hrandib/upsv2/kicad/ups_top.jpg

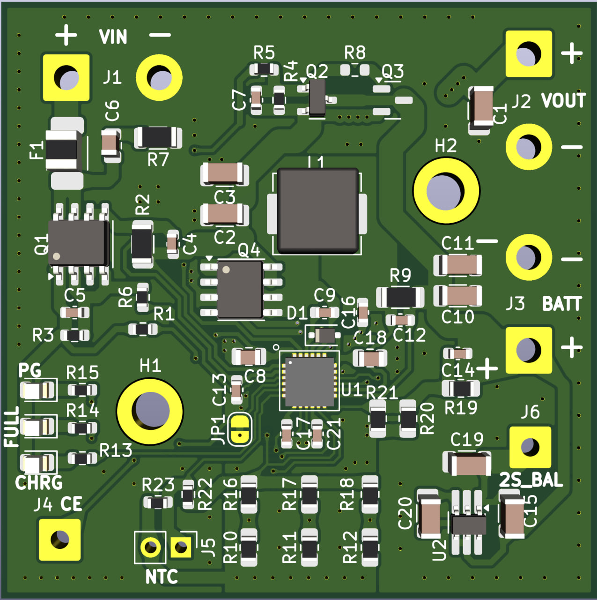
kicad/ups_top.jpg
