hrandib/upsv2/kicad/ups_bottom.jpg

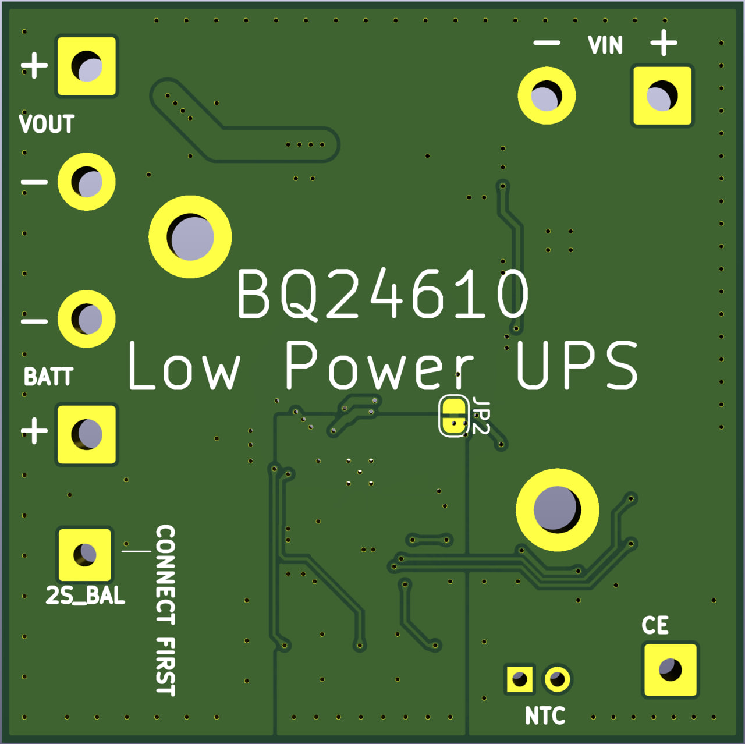
kicad/ups_bottom.jpg
