hrandib/upsv2/kicad/ups.kicad_pcb

## KiCad design kicad/ups.kicad_pcb (2024-06-22)

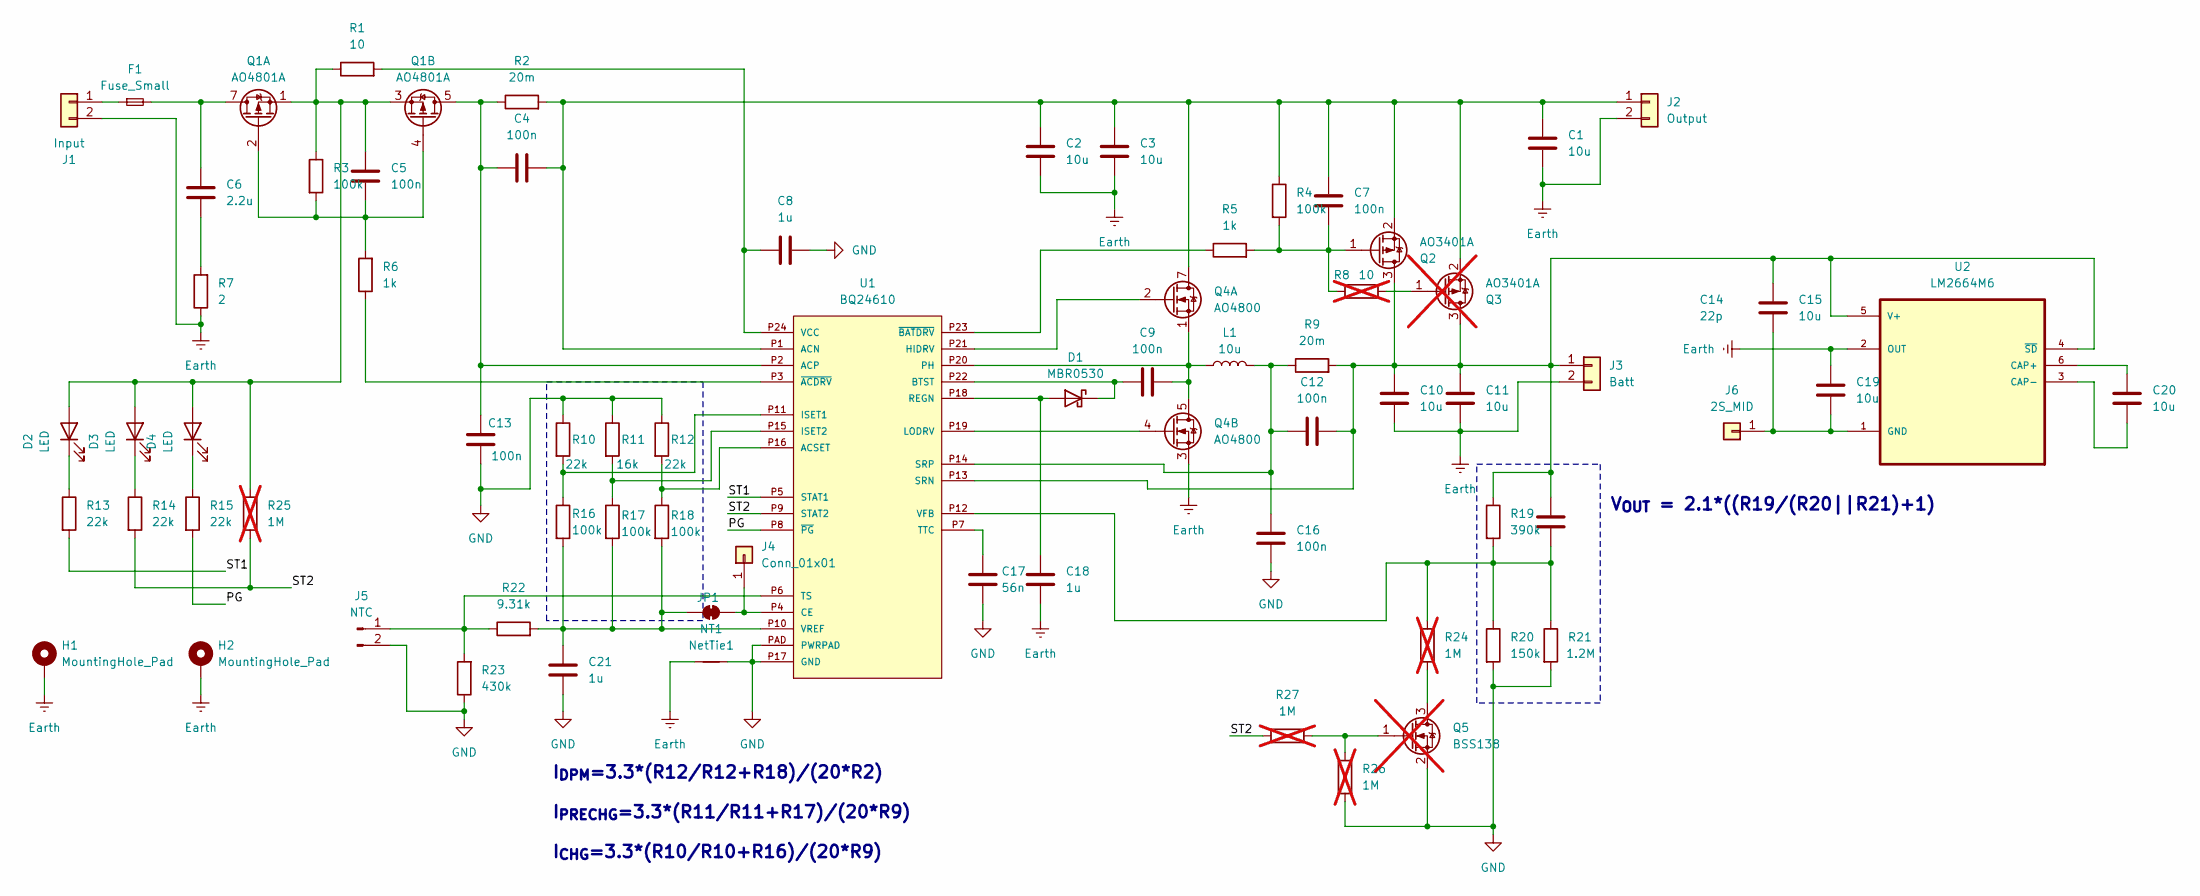
[picture p3: schematic ups.kicad_sch]

Parts:
C1, C2, C3, C10, C11, C15, C19, C20: 10u; C_1206_3216Metric
C4, C5, C7, C9, C12, C13, C16: 100n; C_0603_1608Metric
C6: 2.2u; C_0805_2012Metric
C8, C18: 1u; C_0805_2012Metric
C14: 22p; C_0603_1608Metric
C17: 56n; C_0603_1608Metric
C21: 1u; C_0603_1608Metric
D1: MBR0530; D_SOD-323F
D2, D3, D4: LED; LED_0805_2012Metric
F1: Fuse_Small; Fuse_1812_4532Metric
H1, H2: MountingHole_Pad; MountingHole_3.2mm_M3_DIN965_Pad
J1: Input; SolderWire-1.5sqmm_1x02_P7.8mm_D1.7mm_OD3.9mm
J2: Output; SolderWire-1.5sqmm_1x02_P7.8mm_D1.7mm_OD3.9mm
J3: Batt; SolderWire-1.5sqmm_1x02_P7.8mm_D1.7mm_OD3.9mm
J4: Conn_01x01; SolderWire-0.75sqmm_1x01_D1.25mm_OD3.5mm
J5: NTC; PinHeader_1x02_P2.54mm_Vertical
J6: 2S_MID; SolderWire-0.75sqmm_1x01_D1.25mm_OD3.5mm
JP1: SolderJumper_2_Bridged; SolderJumper-2_P1.3mm_Bridged_RoundedPad1.0x1.5mm
L1: 10u; L_Abracon_ASPI-0630LR
NT1: NetTie1; NetTie-2_SMD_Pad2.0mm
Q1: AO4801A; SOIC-8_3.9x4.9mm_P1.27mm
Q2: AO3401A; SOT-23
Q3: AO3401A; SOT-23; not fitted
Q4: AO4800; SOIC-8_3.9x4.9mm_P1.27mm
Q5: BSS138; SOT-23; not fitted
R1: 10; R_0603_1608Metric
R2, R9: 20m; R_1206_3216Metric
R3, R4: 100k; R_0603_1608Metric
R5, R6: 1k; R_0603_1608Metric
R7: 2; R_1206_3216Metric
R8: 10; R_0603_1608Metric; not fitted
R10, R12: 22k; R_0805_2012Metric_Pad1.20x1.40mm_HandSolder
R11: 16k; R_0805_2012Metric_Pad1.20x1.40mm_HandSolder
R13, R14, R15: 22k; R_0603_1608Metric
R16, R17, R18: 100k; R_0805_2012Metric_Pad1.20x1.40mm_HandSolder
R19: 390k; R_0805_2012Metric_Pad1.20x1.40mm_HandSolder
R20: 150k; R_0805_2012Metric_Pad1.20x1.40mm_HandSolder
R21: 1.2M; R_0805_2012Metric_Pad1.20x1.40mm_HandSolder
R22: 9.31k; R_0603_1608Metric
R23: 430k; R_0603_1608Metric
R24: 1M; R_0805_2012Metric_Pad1.20x1.40mm_HandSolder; not fitted
R25, R26, R27: 1M; R_0603_1608Metric; not fitted
U1: BQ24610; VQFN24_TI
U2: LM2664M6; TSOT-23-6_HandSoldering

Connections:
/PG: R15.2, U1.P8 (~PG)
/ST1: R13.2, U1.P5 (STAT1)
/ST2: R14.2, R25.2, R27.1, U1.P9 (STAT2)
Earth: C1.2, C2.2, C3.2, C10.2, C11.2, C18.2, C19.1, H1.1, H2.1, J1.2, J2.2, J3.2, NT1.2, Q4.3 (S2), R7.1, U2.2 (OUT)
GND: C8.2, C13.1, C16.1, C17.2, C21.2, J5.2, NT1.1, Q5.2 (S), R10.1, R11.1, R12.1, R20.2, R21.2, R23.1, R26.2, U1.P17 (GND), U1.PAD (PWRPAD)
unnamed: C6.1, F1.2, Q1.7 (D1), Q1.8 (D1)
unnamed: C6.2, R7.2
unnamed: C18.1, D1.2 (A), U1.P18 (REGN)
unnamed: C9.1, D1.1 (K), U1.P22 (BTST)
unnamed: C5.1, D2.2 (A), D3.2 (A), D4.2 (A), Q1.1 (S1), Q1.3 (S2), R1.1, R3.1, R25.1
unnamed: D2.1 (K), R13.1
unnamed: D3.1 (K), R14.1
unnamed: D4.1 (K), R15.1
unnamed: F1.1, J1.1
unnamed: C1.1, C2.1, C3.1, C4.2, C7.1, J2.1, Q2.2 (S), Q3.2 (S), Q4.7 (D1), Q4.8 (D1), R2.2, R4.1, U1.P1 (ACN)
unnamed: C10.1, C11.1, C12.2, C14.1, C15.1, J3.1, Q2.3 (D), Q3.3 (D), R9.2, R19.1, U1.P13 (SRN), U2.4 (~SD), U2.5 (V+)
unnamed: J4.1, JP1.2 (B), U1.P4 (CE)
unnamed: J5.1, R22.1, R23.2, U1.P6 (TS)
unnamed: C15.2, C19.2, J6.1, U2.1 (GND)
unnamed: C21.1, JP1.1 (A), R16.2, R17.2, R18.2, R22.2, U1.P10 (VREF)
unnamed: C5.2, Q1.2 (G1), Q1.4 (G2), R3.2, R6.2
unnamed: C7.2, Q2.1 (G), R4.2, R5.2, R8.1
unnamed: Q3.1 (G), R8.2
unnamed: Q4.2 (G1), U1.P21 (HIDRV)
unnamed: C9.2, L1.1, Q4.1 (S1), Q4.5 (D2), Q4.6 (D2), U1.P20 (PH)
unnamed: Q4.4 (G2), U1.P19 (LODRV)
unnamed: Q5.3 (D), R24.2
unnamed: Q5.1 (G), R26.1, R27.2
unnamed: C4.1, C13.2, Q1.5 (D2), Q1.6 (D2), R2.1, U1.P2 (ACP)
unnamed: R12.2, R18.1, U1.P16 (ACSET)
unnamed: R10.2, R16.1, U1.P11 (ISET1)
unnamed: R11.2, R17.1, U1.P15 (ISET2)
unnamed: C12.1, C16.2, L1.2, R9.1, U1.P14 (SRP)
unnamed: C17.1, U1.P7 (TTC)
unnamed: C8.1, R1.2, U1.P24 (VCC)
unnamed: C14.2, R19.2, R20.1, R21.1, R24.1, U1.P12 (VFB)
unnamed: R6.1, U1.P3 (~ACDRV)
unnamed: R5.1, U1.P23 (~BATDRV)
unnamed: C20.1, U2.6 (CAP+)
unnamed: C20.2, U2.3 (CAP-)

Notes on the sheet:
V_{OUT} = 2.1*((R19/(R20||R21)+1)
I_{DPM}=3.3*(R12/R12+R18)/(20*R2) I_{PRECHG}=3.3*(R11/R11+R17)/(20*R9) I_{CHG}=3.3*(R10/R10+R16)/(20*R9)

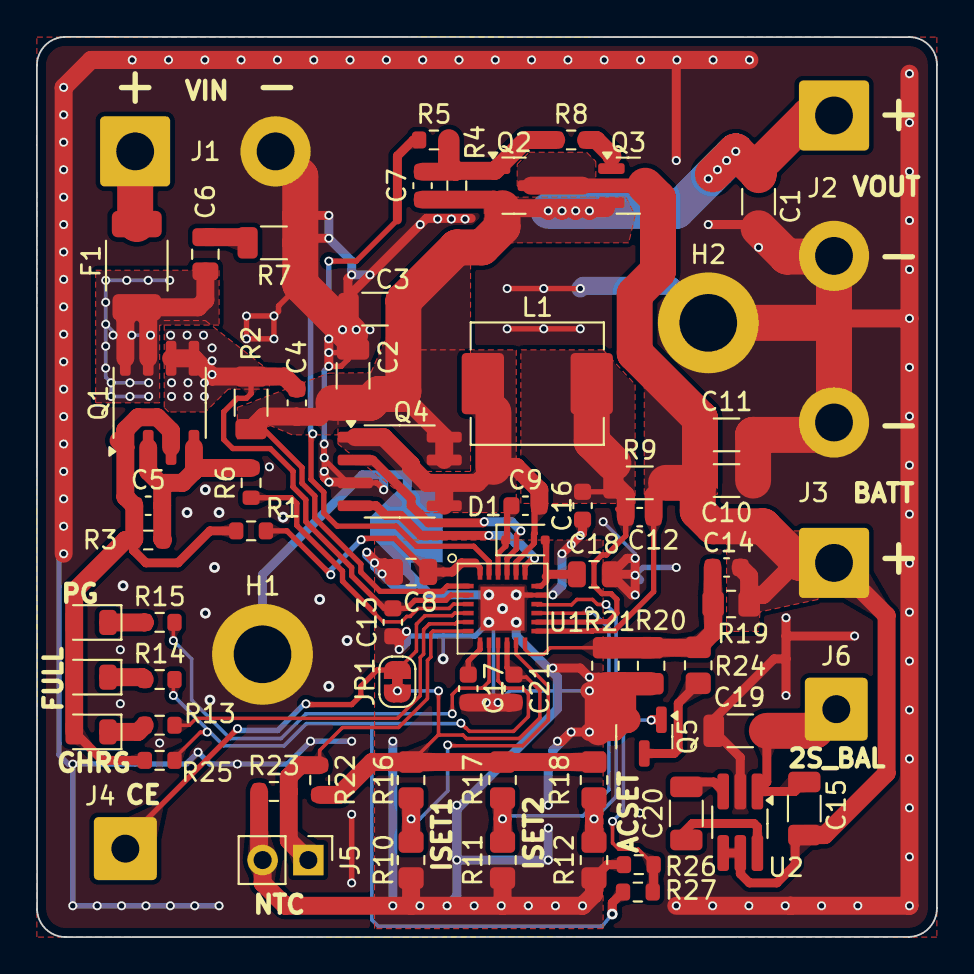
[picture p4: board ups.kicad_pcb from above]

Board: 2 copper layers, 50.0 x 50.0 mm, 71 parts (1 on the bottom side), 40 nets.
