hrandib/upsv2/(commit log)

2024-05-27 Add schematics
    [ups.kicad_pcb, ups.kicad_sch]
2024-05-28 Add PCB and Gerbers
    [ups-B_Cu.gbl, ups-B_Mask.gbs, ups-B_Paste.gbp, ups-B_Silkscreen.gbo, ups-Edge_Cuts.gm1, ups-F_Cu.gtl, ups-F_Mask.gts, ups-F_Paste.gtp]
2024-05-28 Minor pcb fix
    [ups.kicad_pcb]
2024-05-28 Add ACSET ISETx labels to silkscreen
    [ups.kicad_pcb]
2024-05-28 Minor pcb rerouting
    [ups.kicad_pcb]
2024-05-28 Cleanup ground polygon islands
    [ups.kicad_pcb]
2024-06-01 Add recharge threshold control
    [ups.kicad_pcb, ups.kicad_sch]
2024-06-01 Minor reroute
    [ups.kicad_pcb]
2024-06-02 More copper for the input mosfet
    [ups.kicad_pcb]
2024-06-22 Update part names, minor fix in the ground plane
    [ups.kicad_pcb, ups.kicad_sch]
2024-06-22 pcb: Add interactive BOM
2024-06-22 pcb: Update part names
    [ups.kicad_pcb]
2024-06-22 Add equation formulas to schematics
    [ups.kicad_sch]
2024-06-22 Remove outdated Gerber files
    [ups-B_Cu.gbl, ups-B_Mask.gbs, ups-B_Paste.gbp, ups-B_Silkscreen.gbo, ups-Edge_Cuts.gm1, ups-F_Cu.gtl, ups-F_Mask.gts, ups-F_Paste.gtp]
2024-06-22 Update iBOM
    [ups.kicad_pcb]
2024-06-23 sch: Fix precharge equation
    [ups.kicad_sch]
